bwillaert/WaterLevelSensor/Measurements/capacitive_oscillator_pin3.jpg

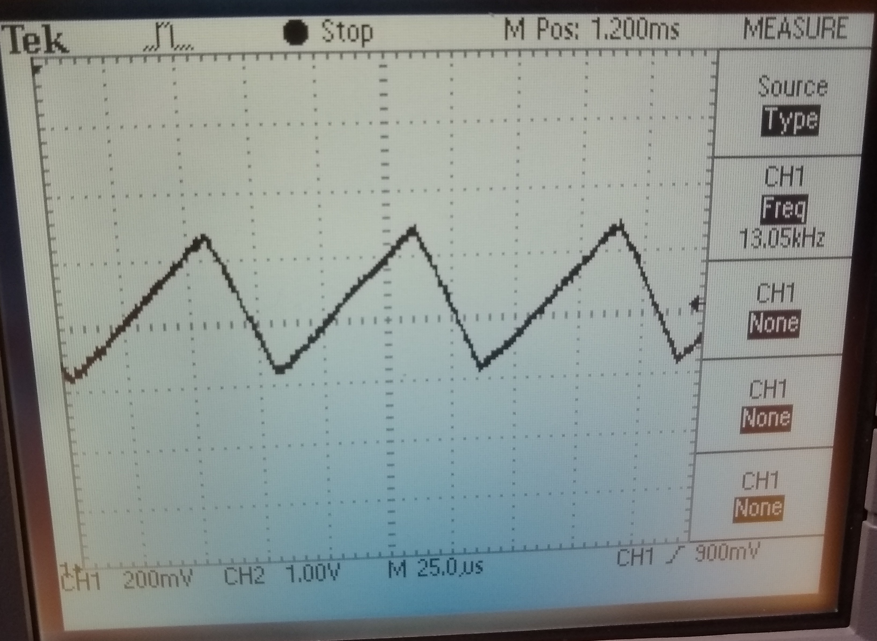
Measurements/capacitive_oscillator_pin3.jpg
