bwillaert/WaterLevelSensor/Proto/IMG_20221228_154319753.jpg

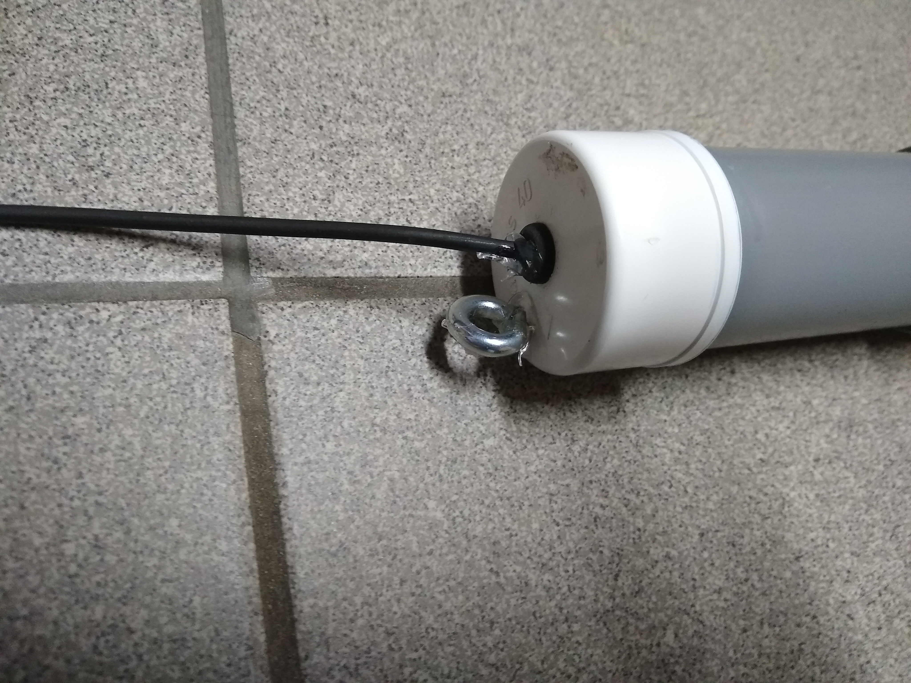
Proto/IMG_20221228_154319753.jpg
