bwillaert/WaterLevelSensor/SW/WaterLevelSensor/README.md

# WaterLevelSensor
Capacitive water level sensor
