bwillaert/WaterLevelSensor/Components/Watersensor.docx

CONRAD

Wartel flexible 2.5 mm min

https://www.conrad.be/nl/p/lapp-53015800-wartel-pg7-polyamide-zwart-ral-9005-1-stuk-s-526869.html

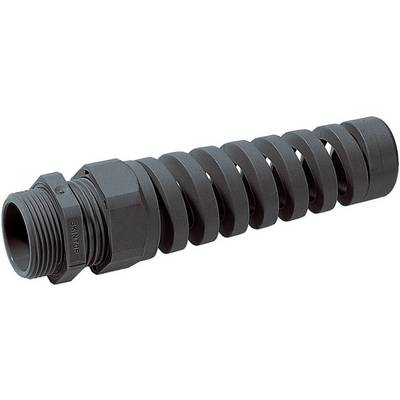
[picture p3: figure]
LAPP 53015800 Wartel PG7 Polyamide Zwart (RAL 9005) 1 stuk(s)

Wartel vast 2.5 mm min

https://www.conrad.be/nl/p/lapp-53015200-wartel-pg7-polyamide-zwart-ral-9005-1-stuk-s-527168.html

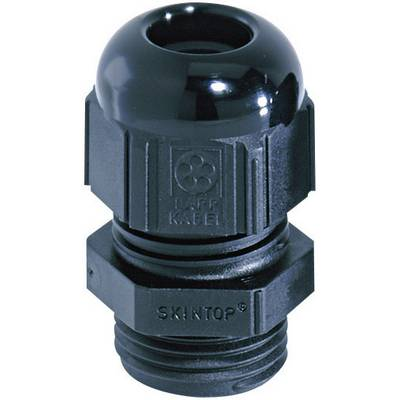
[picture p4: figure]
LAPP 53015200 Wartel PG7 Polyamide Zwart (RAL 9005) 1 stuk(s)

Moer wartel PG7
https://www.conrad.be/nl/p/lapp-skintop-gmp-gl-pg7-contramoer-pg7-polyamide-zwart-ral-9005-1-stuk-s-527078.html

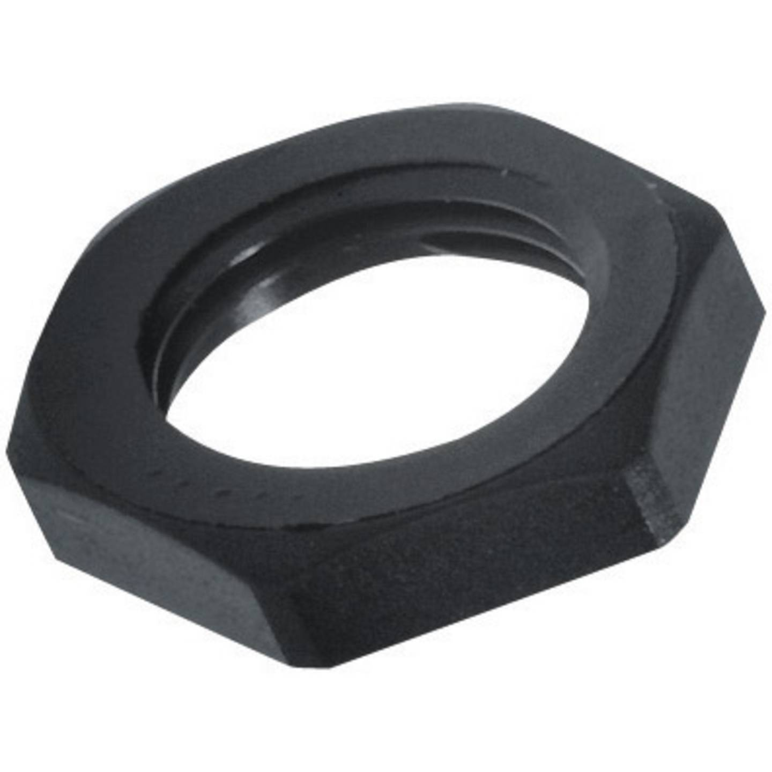
[picture p5: figure]

Behuizing controller

https://www.conrad.be/nl/p/fibox-ta131007-wandbehuizing-130-x-95-x-65-abs-grijs-wit-ral-7035-1-stuk-s-533265.html

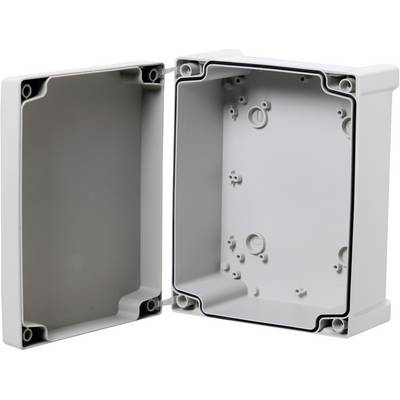
[picture p6: figure]
Fibox TA131007 Wandbehuizing 130 x 95 x 65 ABS Grijs-wit (RAL 7035) 1 stuk(s)

Behuizing sensor

https://www.conrad.be/nl/p/tru-components-wf20-2-tc-6649484-universele-behuizing-63-x-58-x-35-abs-lichtgrijs-1-stuk-s-1662371.html

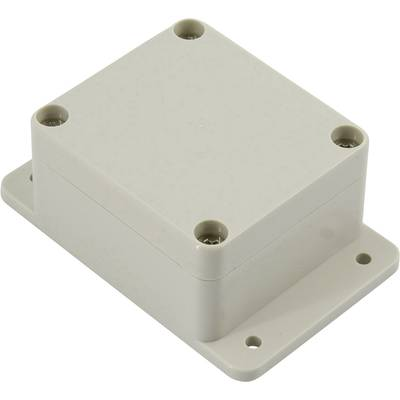
[picture p7: figure]
TRU COMPONENTS WF3-2 TC-6649488 Universele behuizing 115 x 55 x 90 ABS Lichtgrijs 1 stuk(s)

https://www.conrad.be/nl/p/hammond-electronics-1591mf2sgy-universele-behuizing-85-x-56-x-26-abs-grijs-1-stuk-s-485555.html

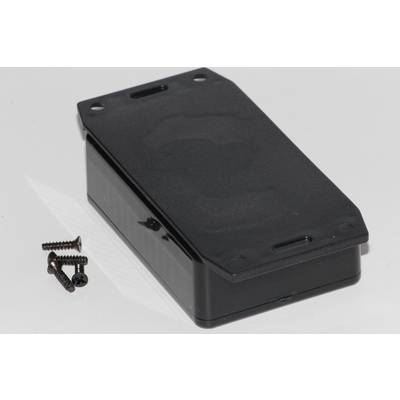
[picture p8: figure]
Hammond Electronics 1591MF2SGY Universele behuizing 85 x 56 x 26 ABS Grijs 1 stuk(s)

https://www.conrad.be/nl/p/hammond-electronics-1591bf2sbk-universele-behuizing-112-x-62-x-31-abs-zwart-1-stuk-s-485537.html

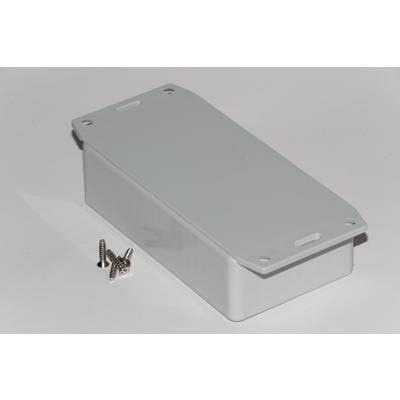
[picture p9: figure]
Hammond Electronics 1591BF2SBK Universele behuizing 112 x 62 x 31 ABS Zwart 1 stuk(s)

https://www.conrad.be/nl/p/tru-components-tc-10860484-universele-behuizing-105-x-70-x-40-polycarbonaat-lichtgrijs-1-stuk-s-2715121.html

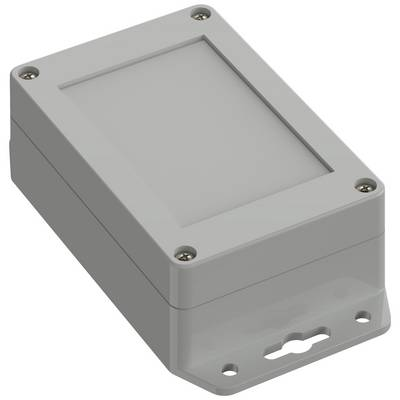
[picture p10: figure]
TRU COMPONENTS TC-10860484 Universele behuizing 105 x 70 x 40 Polycarbonaat Lichtgrijs 1 stuk(s)

Druktoets calibratie

https://www.conrad.be/nl/p/namae-electronics-jtp-1130l-druktoets-12-v-dc-0-05-a-1x-uit-aan-moment-1-stuk-s-705338.html

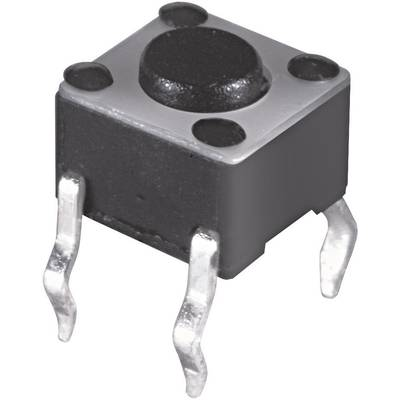
[picture p11: figure]
Namae Electronics JTP-1130L Druktoets 12 V/DC 0.05 A 1x uit/(aan) Moment 1 stuk(s)

Rode toets:
https://www.conrad.be/nl/p/te-connectivity-tactile-switchestactile-switches-3-1825910-1-amp-2455174.html

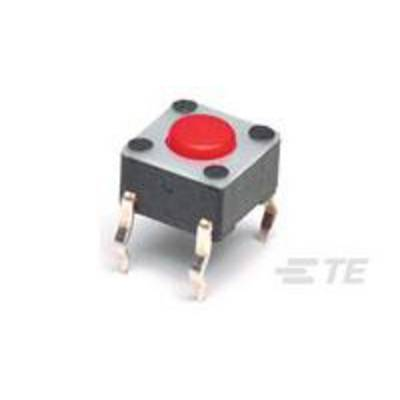
[picture p12: figure]
TE Connectivity Tactile SwitchesTactile Switches 3-1825910-1 AMP

Druktoets meter

https://www.conrad.be/nl/p/tru-components-tc-mt312sw-druktoets-moment-1-stuk-s-1589484.html

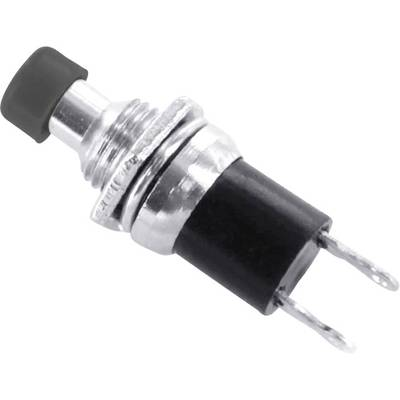
[picture p13: figure]
TRU COMPONENTS TC-MT312SW Druktoets Moment 1 stuk(s)

https://www.conrad.be/nl/p/tru-components-tc-r13-507a-05bk-druktoets-250-v-ac-3-a-1x-uit-aan-moment-1-stuk-s-1587737.html

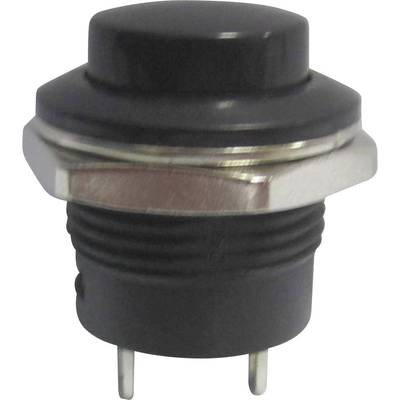
[picture p14: figure]
TRU COMPONENTS TC-R13-507A-05BK Druktoets 250 V/AC 3 A 1x uit/(aan) Moment 1 stuk(s)

Meter 100 microA

https://www.conrad.be/nl/p/analoog-inbouwmeetapparaat-voltcraft-am-60x46-100-a-dc-100-a-n-a-103537.html

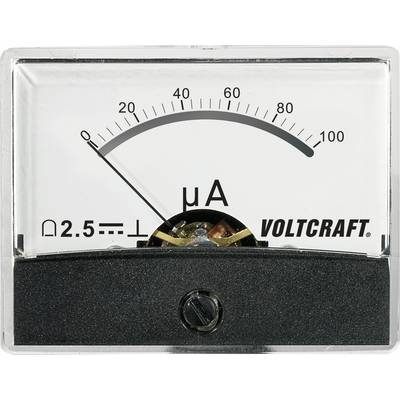
[picture p15: figure]
Analoog inbouwmeetapparaat VOLTCRAFT AM-60X46/100µA/DC 100 µA N/A

https://nl.aliexpress.com/item/32963269702.html

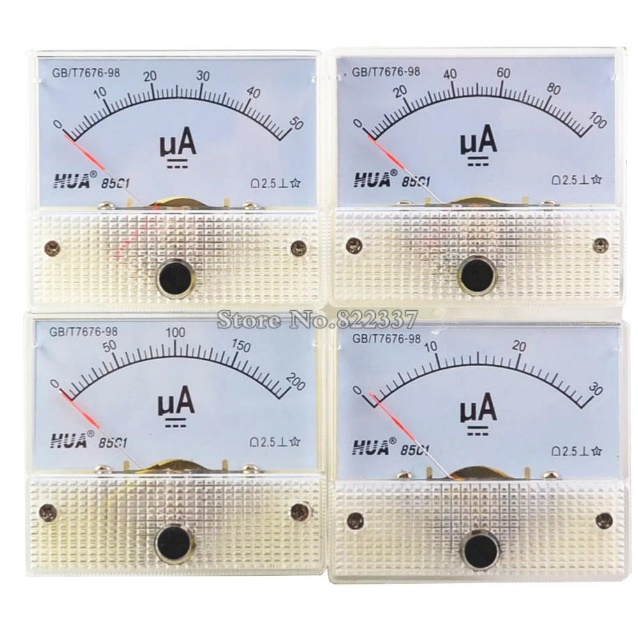
[picture p16: figure]

https://elektrodump.nl/nl/paneelmeters/1827-paneelmeter.html

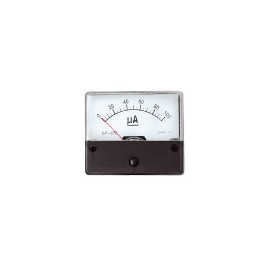
[picture p17: figure]
paneelmeter

Stereo chassis input

https://www.conrad.be/nl/p/tru-components-718817-jackplug-3-5-mm-bus-inbouw-verticaal-aantal-polen-3-stereo-zwart-1-stuk-s-718817.html

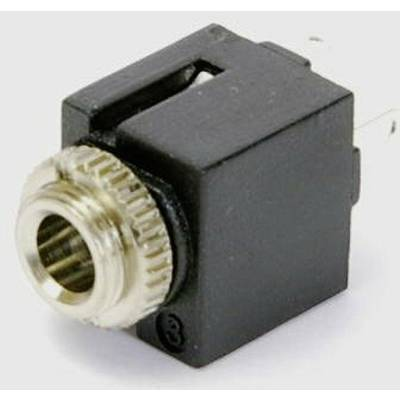
[picture p18: figure]
TRU COMPONENTS 718817 Jackplug 3.5 mm Bus, inbouw verticaal Aantal polen: 3 Stereo Zwart 1 stuk(s)

Stereo jack plug

https://www.conrad.be/nl/p/tru-components-595194-jackplug-3-5-mm-stekker-recht-aantal-polen-3-stereo-zwart-1-stuk-s-1567385.html

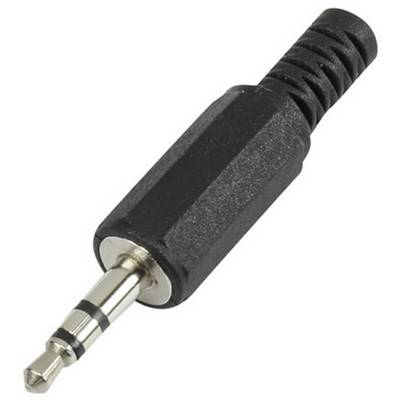
[picture p19: figure]
TRU COMPONENTS 595194 Jackplug 3.5 mm Stekker, recht Aantal polen: 3 Stereo Zwart 1 stuk(s)

555

https://www.conrad.be/nl/p/on-semiconductor-lm555cn-clock-timing-ic-timer-oscillator-dip-8-1253093.html

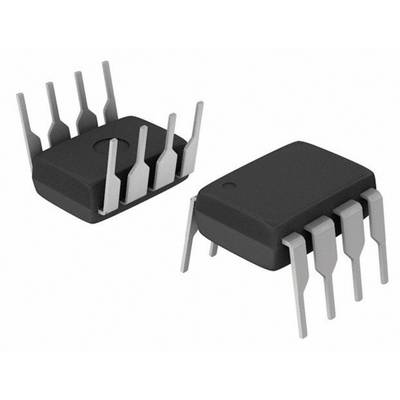
[picture p20: figure]
ON Semiconductor LM555CN Clock/timing-IC - timer, oscillator DIP-8

Kabel sensor

https://www.conrad.be/nl/p/kash-1339360-microfoonkabel-2-x-0-12-mm-zwart-per-meter-1339360.html

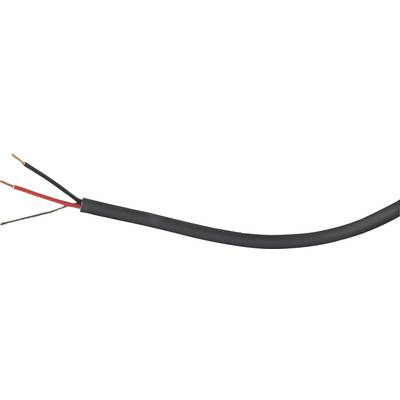
[picture p21: figure]
Kash 1339360 Microfoonkabel 2 x 0.12 mm² Zwart per meter

Kabel 3 aders

https://www.conrad.be/nl/p/lapp-28203-1-datakabel-unitronic-liyy-3-x-0-14-mm-kiezel-grijs-ral-7032-per-meter-602153.html

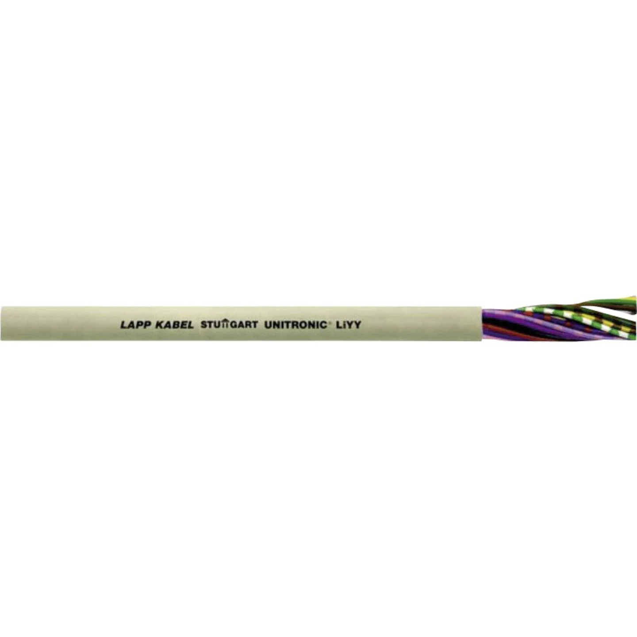
[picture p22: figure]

https://www.conrad.be/nl/p/faber-kabel-liyy-stuurstroomkabel-3-x-0-34-mm-grijs-030220-per-meter-1152513.html

>>>> https://www.conrad.be/nl/p/faber-kabel-liyy-stuurstroomkabel-3-x-0-14-mm-grijs-030175-per-meter-1152511.htm

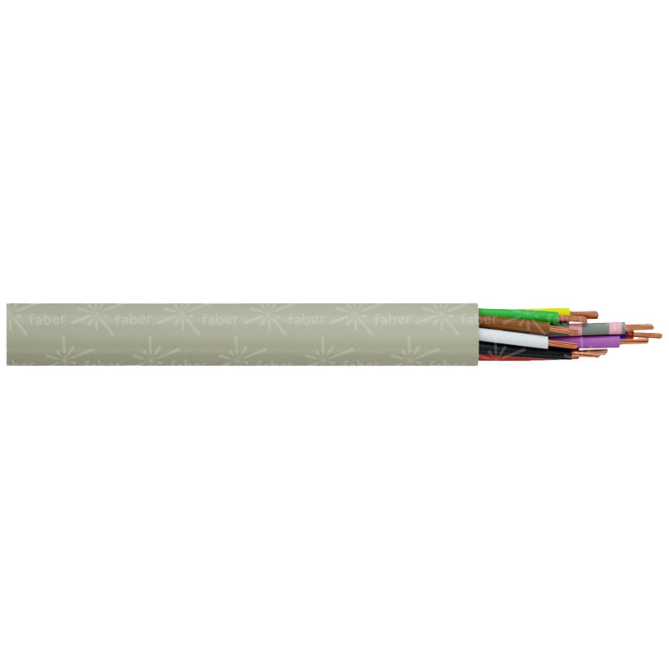
[picture p23: figure]

LED rood / groen

https://www.conrad.be/nl/p/vossloh-schwabe-cqx-95-led-meerkleurig-rood-groen-rond-5-mm-90-mcd-70-mcd-60-20-ma-2-v-2-1-v-185000.html

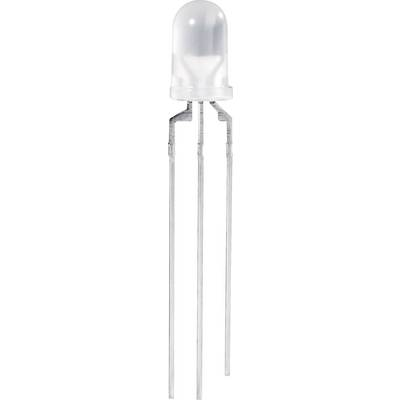
[picture p24: figure]
Vossloh Schwabe CQX 95 LED meerkleurig Rood, Groen Rond 5 mm 90 mcd, 70 mcd 60 ° 20 mA 2 V, 2.1 V

Multifuse 100 mA

https://www.conrad.be/nl/p/eska-frx010-60f-ptc-zekering-drempelstroom-i-h-0-1-a-60-v-l-x-b-x-h-5-7-x-3-1-x-18-5-mm-1-stuk-s-524748.html

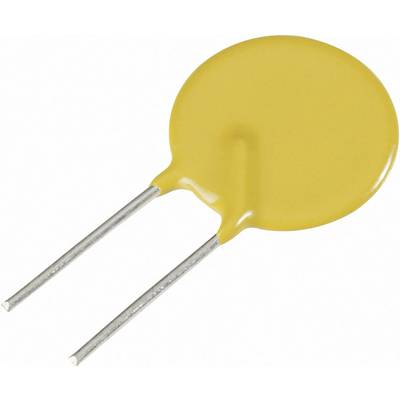
[picture p25: figure]
ESKA FRX010-60F PTC-zekering Drempelstroom I(H) 0.1 A 60 V (l x b x h) 5.7 x 3.1 x 18.5 mm 1 stuk(s)

Eindkappen sensor draad

https://www.conrad.be/nl/p/hellermanntyton-416-00000-warmkrimpende-eindkap-nominale-binnen-voor-krimpen-3-mm-1-stuk-s-542462.html

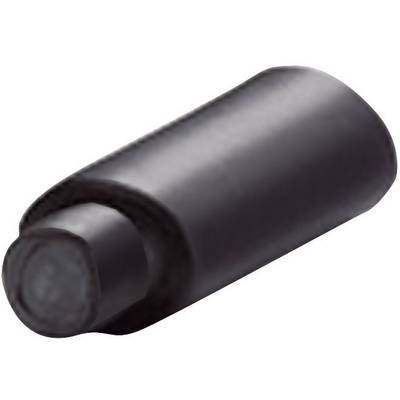
[picture p26: figure]
HellermannTyton 416-00000 Warmkrimpende eindkap Nominale binnen-Ø (voor krimpen): 3 mm 1 stuk(s)

https://www.conrad.be/nl/p/tru-components-1592743-eindkap-niet-krimpend-nominale-binnen-voor-krimpen-3-mm-100-stuk-s-1592743.html

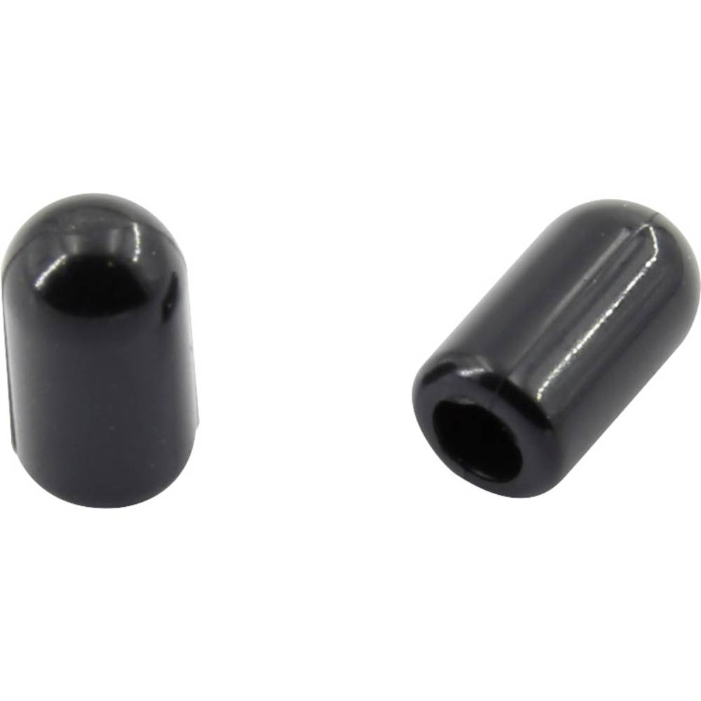
[picture p27: figure]

HUBO 32 mm PVC behuizing sensor:

https://www.hubo.be/nl/p/scala-stop-met-schroef-32mm-grijs/815025.html

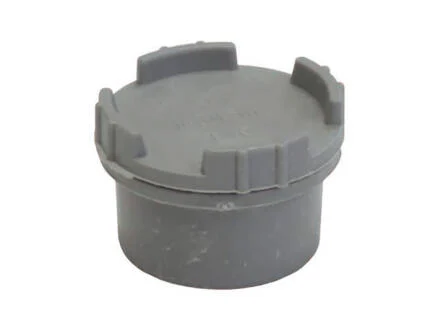
[picture p28: figure]

https://www.hubo.be/nl/p/scala-lijmmof-32mm-grijs/815019.html

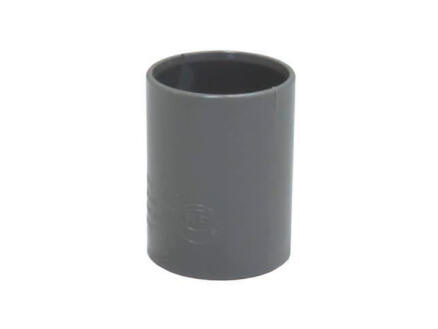
[picture p29: figure]

Eindkap 32 mm wit
https://www.gamma.be/nl/assortiment/martens-eindkap-voor-buis-pvc-wit-32-mm/p/B120335

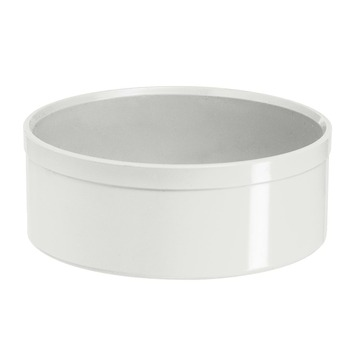
[picture p30: figure]

Eindkap 40 mm Brico grijs

https://www.brico.be/nl/bouwmaterialen/waterafvoer/afvoer-en-rioleringsbuizen/martens-eindkap-voor-buis-40-mm/4207159

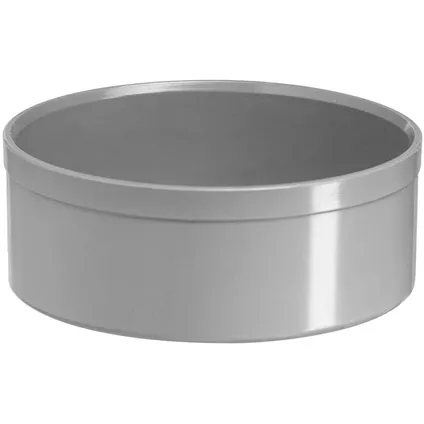
[picture p31: figure]
