bwillaert/WaterLevelSensor/PCB/WLS3/WLS3/wls3.pdf/WLS3.pdf

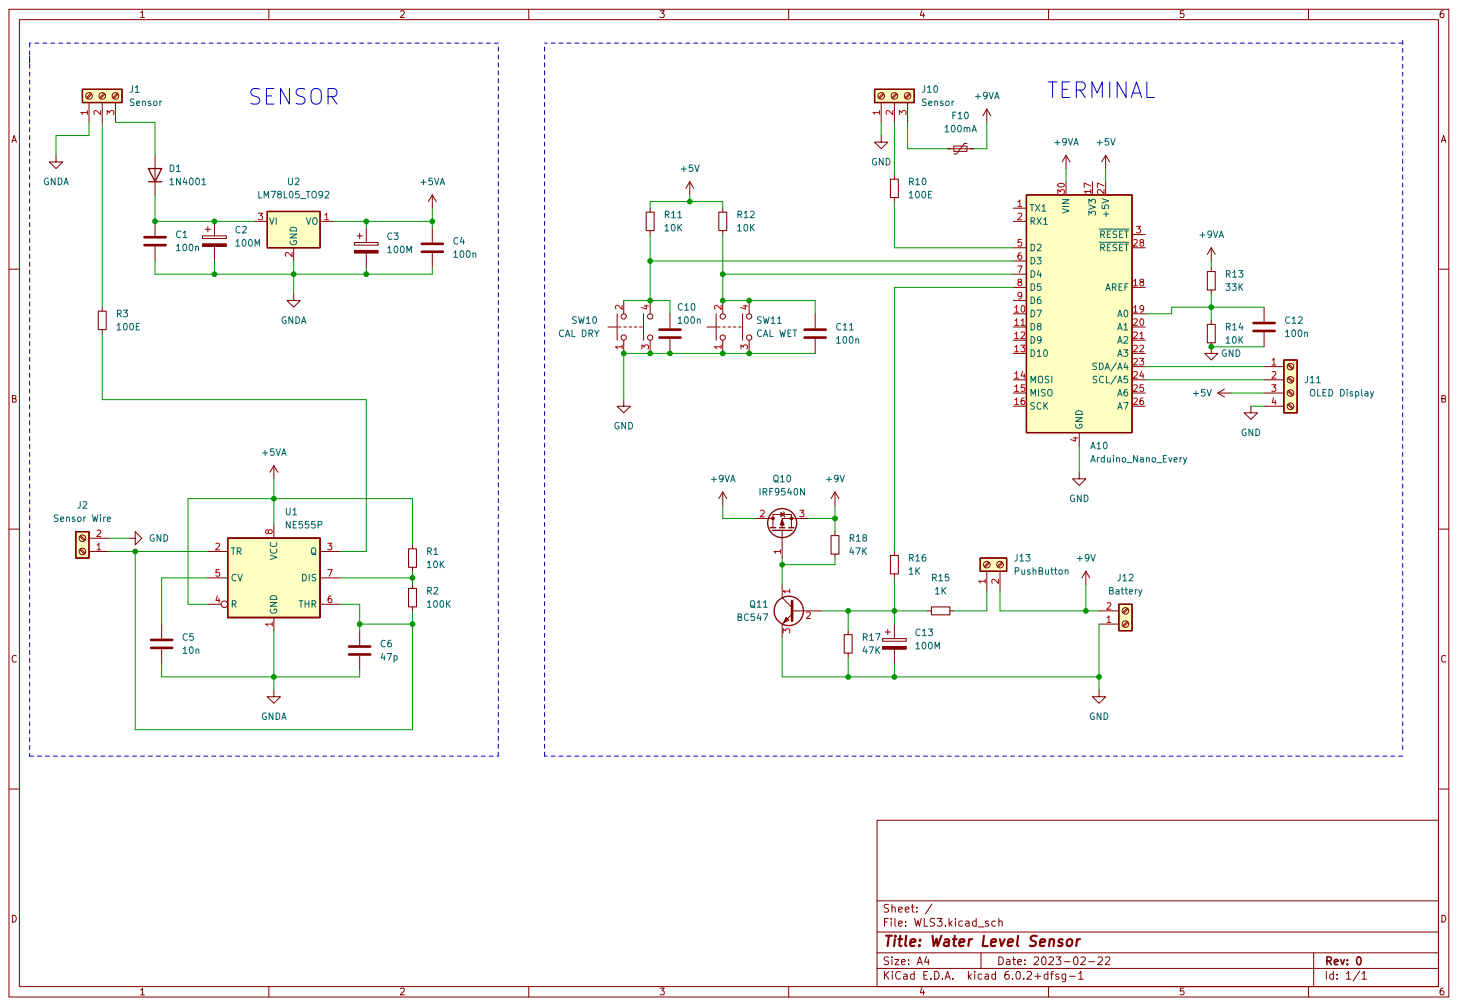
[picture p32: page 1]

File: WLS3.kicad_sch Sheet: /
Id: 1/1 Title: Water Level Sensor
