bwillaert/WaterLevelSensor/PCB/WLS5/WLS5/WLS5.kicad_pcb

## KiCad design PCB/WLS5/WLS5/WLS5.kicad_pcb (2023-09-03)

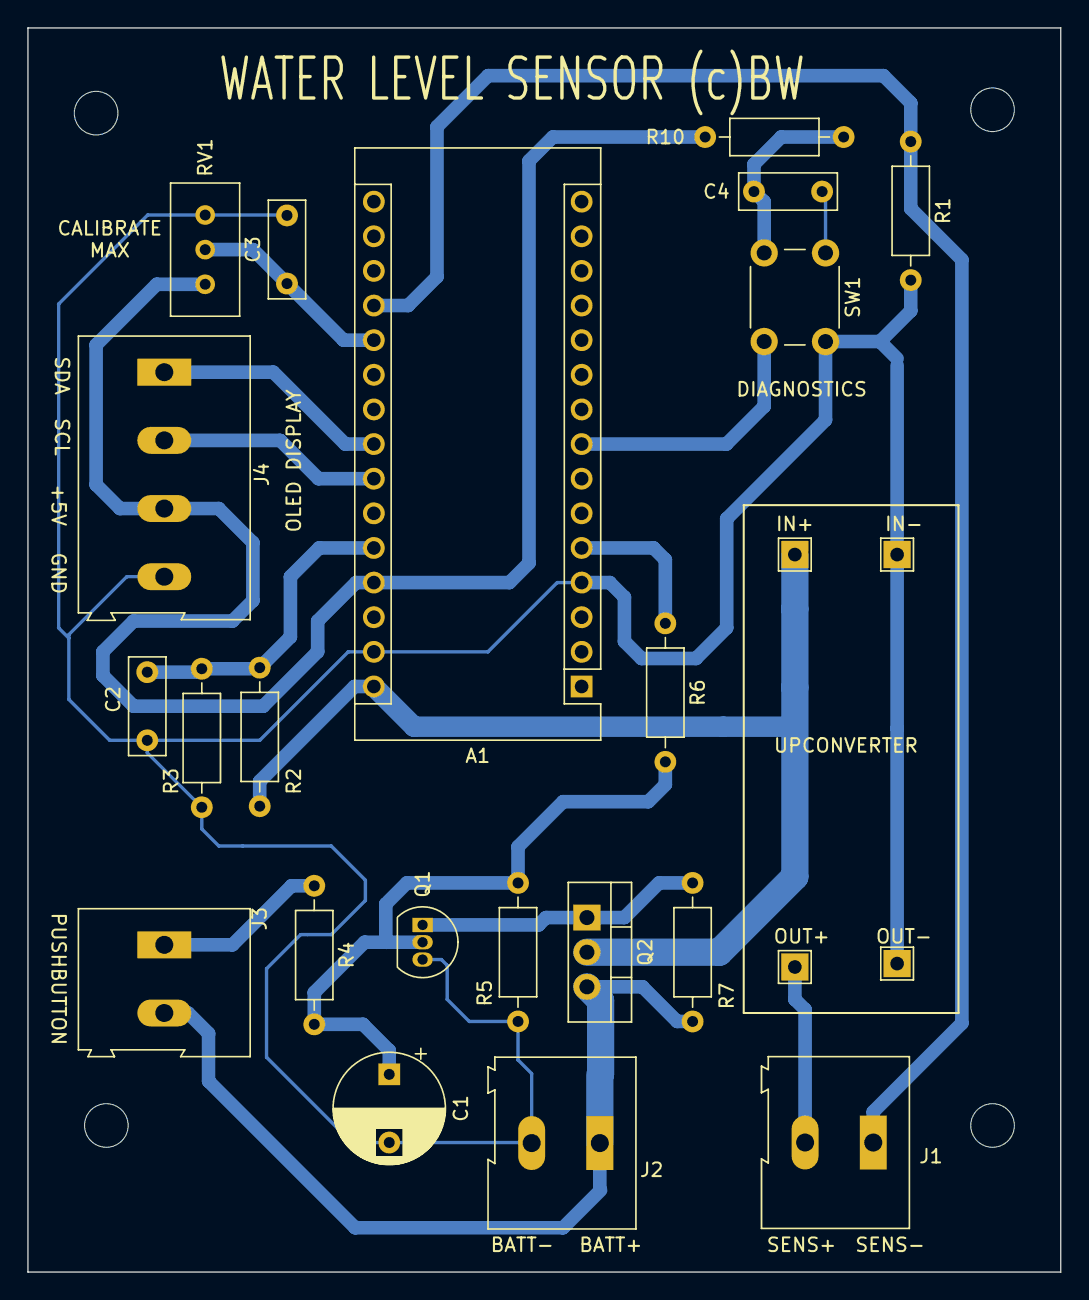
[picture p33: board WLS5.kicad_pcb from above]

Board: 2 copper layers, 75.8 x 91.2 mm, 29 parts (0 on the bottom side), 15 nets.

Parts:
A1: Arduino_Nano_Every; Arduino_Nano
C1: 100M; CP_Radial_D8.0mm_P5.00mm
C2, C3, C4: 100n; C_Disc_D7.0mm_W2.5mm_P5.00mm
H1, H2, H3, H4: MountingHole; MountingHole_3.2mm_M3
IN+: IN+; TestPoint_THTPad_2.0x2.0mm_Drill1.0mm
IN-: IN-; TestPoint_THTPad_2.0x2.0mm_Drill1.0mm
J1: Sensor; TerminalBlock_Altech_AK300-2_P5.00mm
J2: Battery; TerminalBlock_Altech_AK300-2_P5.00mm
J3: PushButton; TerminalBlock_Altech_AK300-2_P5.00mm
J4: OLED Display; TerminalBlock_Altech_AK300-4_P5.00mm
OUT+: UP+; TestPoint_THTPad_2.0x2.0mm_Drill1.0mm
OUT-: UP-; TestPoint_THTPad_2.0x2.0mm_Drill1.0mm
Q1: BC547; TO-92_Inline
Q2: IRF9540N; TO-220-3_Vertical
R1: 220E; R_Axial_DIN0207_L6.3mm_D2.5mm_P10.16mm_Horizontal
R2: 33K; R_Axial_DIN0207_L6.3mm_D2.5mm_P10.16mm_Horizontal
R3, R10: 10K; R_Axial_DIN0207_L6.3mm_D2.5mm_P10.16mm_Horizontal
R4, R6: 1K; R_Axial_DIN0207_L6.3mm_D2.5mm_P10.16mm_Horizontal
R5, R7: 47K; R_Axial_DIN0207_L6.3mm_D2.5mm_P10.16mm_Horizontal
RV1: Calibrate max; Potentiometer_Bourns_3296W_Vertical
SW1: DIAGNOSTICS; SW_PUSH_6mm

Connections:
+5V: A1.27 (+5V), J4.3, R10.1, RV1.1
+9V: J2.1, J3.2, Q2.3 (S), R7.1
+9VA: A1.30 (VIN), IN+.1, Q2.2 (D), R2.1
GND: A1.4 (GND), A1.29 (GND), C1.2, C2.2, C3.2, C4.2, IN-.1, J2.2, J4.4, OUT-.1, Q1.3 (E), R1.2, R3.2, R5.2, RV1.3, SW1.1
unnamed: A1.5 (D2), R6.1
unnamed: A1.8 (D5), C4.1, R10.2, SW1.2
unnamed: A1.20 (A1), C3.1, RV1.2
unnamed: A1.23 (SDA/A4), J4.1
unnamed: A1.24 (SCL/A5), J4.2
unnamed: A1.26 (A7), C2.1, R2.2, R3.1
unnamed: C1.1, Q1.2 (B), R4.2, R5.1, R6.2
unnamed: A1.19 (A0), J1.1, R1.1
unnamed: J3.1, R4.1
unnamed: J1.2, OUT+.1
unnamed: Q1.1 (C), Q2.1 (G), R7.2
