bwillaert/WaterLevelSensor/PCB/WLS3/WLS3/WLS3.kicad_pcb

## KiCad design PCB/WLS3/WLS3/WLS3.kicad_pcb (2023-06-13)

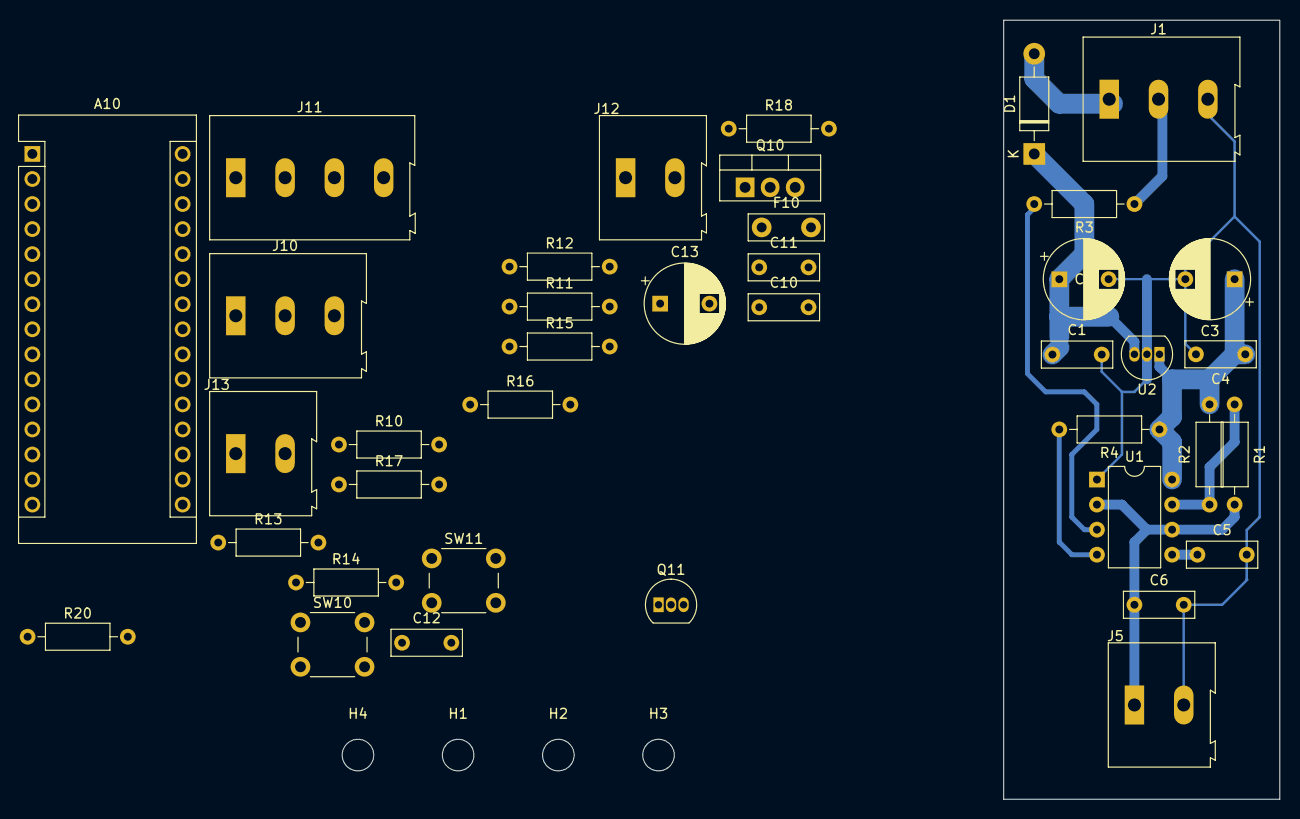
[picture p34: board WLS3.kicad_pcb from above]

Board: 2 copper layers, 28.0 x 79.0 mm, 43 parts (0 on the bottom side), 27 nets.

Parts:
A10: Arduino_Nano_Every; Arduino_Nano
C1, C4, C10, C11, C12: 100n; C_Disc_D7.0mm_W2.5mm_P5.00mm
C2, C3, C13: 100M; CP_Radial_D8.0mm_P5.00mm
C5: 10n; C_Disc_D7.0mm_W2.5mm_P5.00mm
C6: 22p; C_Disc_D7.0mm_W2.5mm_P5.00mm
D1: 1N4001; D_DO-41_SOD81_P10.16mm_Horizontal
F10: 100mA; C_Disc_D7.5mm_W2.5mm_P5.00mm
H1, H2, H3, H4: MountingHole; MountingHole_3.2mm_M3
J1, J10: Sensor; TerminalBlock_Altech_AK300-3_P5.00mm
J5: Sensor Wire; TerminalBlock_Altech_AK300-2_P5.00mm
J11: OLED Display; TerminalBlock_Altech_AK300-4_P5.00mm
J12: Battery; TerminalBlock_Altech_AK300-2_P5.00mm
J13: PushButton; TerminalBlock_Altech_AK300-2_P5.00mm
Q10: IRF9540N; TO-220-3_Vertical
Q11: BC547; TO-92_Inline
R1, R11, R12, R14: 10K; R_Axial_DIN0207_L6.3mm_D2.5mm_P10.16mm_Horizontal
R2: 100K; R_Axial_DIN0207_L6.3mm_D2.5mm_P10.16mm_Horizontal
R3, R10, R20: 100E; R_Axial_DIN0207_L6.3mm_D2.5mm_P10.16mm_Horizontal
R4: 10E; R_Axial_DIN0207_L6.3mm_D2.5mm_P10.16mm_Horizontal
R13: 33K; R_Axial_DIN0207_L6.3mm_D2.5mm_P10.16mm_Horizontal
R15, R16: 1K; R_Axial_DIN0207_L6.3mm_D2.5mm_P10.16mm_Horizontal
R17, R18: 47K; R_Axial_DIN0207_L6.3mm_D2.5mm_P10.16mm_Horizontal
SW10: CAL DRY; SW_PUSH_6mm_H5mm
SW11: CAL WET; SW_PUSH_6mm_H5mm
U1: NE555P; DIP-8_W7.62mm
U2: LM78L05_TO92; TO-92_Inline

Connections:
+5V: A10.27 (+5V), J11.3, R11.1, R12.1
+5VA: C3.1, C4.1, R1.1, R4.1, U1.8 (VCC), U2.1 (VO)
+9V: J12.2, J13.2, Q10.3 (S), R18.1
+9VA: A10.30 (VIN), F10.1, Q10.2 (D), R13.1
GND: A10.4 (GND), A10.29 (GND), C10.2, C11.2, C12.2, C13.2, J10.1, J11.4, J12.1, Q11.3 (E), R14.2, R17.2, SW10.1, SW11.1
GNDA: C1.2, C2.2, C3.2, C4.2, C5.2, C6.2, J1.3, J5.2, U1.1 (GND), U2.2 (GND)
unnamed: A10.2 (RX1), R20.2
unnamed: A10.5 (D2), R10.2
unnamed: A10.6 (D3), C10.1, R11.2, SW10.2
unnamed: A10.7 (D4), C11.1, R12.2, SW11.2
unnamed: A10.8 (D5), R16.1
unnamed: A10.19 (A0), C12.1, R13.2, R14.1
unnamed: A10.23 (SDA/A4), J11.1
unnamed: A10.24 (SCL/A5), J11.2
unnamed: C1.1, C2.1, D1.1 (K), U2.3 (VI)
unnamed: C5.1, U1.5 (CV)
unnamed: C6.1, J5.1, R2.2, U1.2 (TR), U1.6 (THR)
unnamed: C13.1, Q11.2 (B), R15.2, R16.2, R17.1
unnamed: D1.2 (A), J1.1
unnamed: F10.2, J10.3
unnamed: J10.2, R10.1, R20.1
unnamed: J13.1, R15.1
unnamed: Q10.1 (G), Q11.1 (C), R18.2
unnamed: R1.2, R2.1, U1.7 (DIS)
unnamed: J1.2, R3.1
unnamed: R4.2, U1.4 (R)
unnamed: R3.2, U1.3 (Q)
