bwillaert/WaterLevelSensor/PCB/WLS/WLS.brd

## EAGLE design PCB/WLS/WLS.brd (2023-05-29)

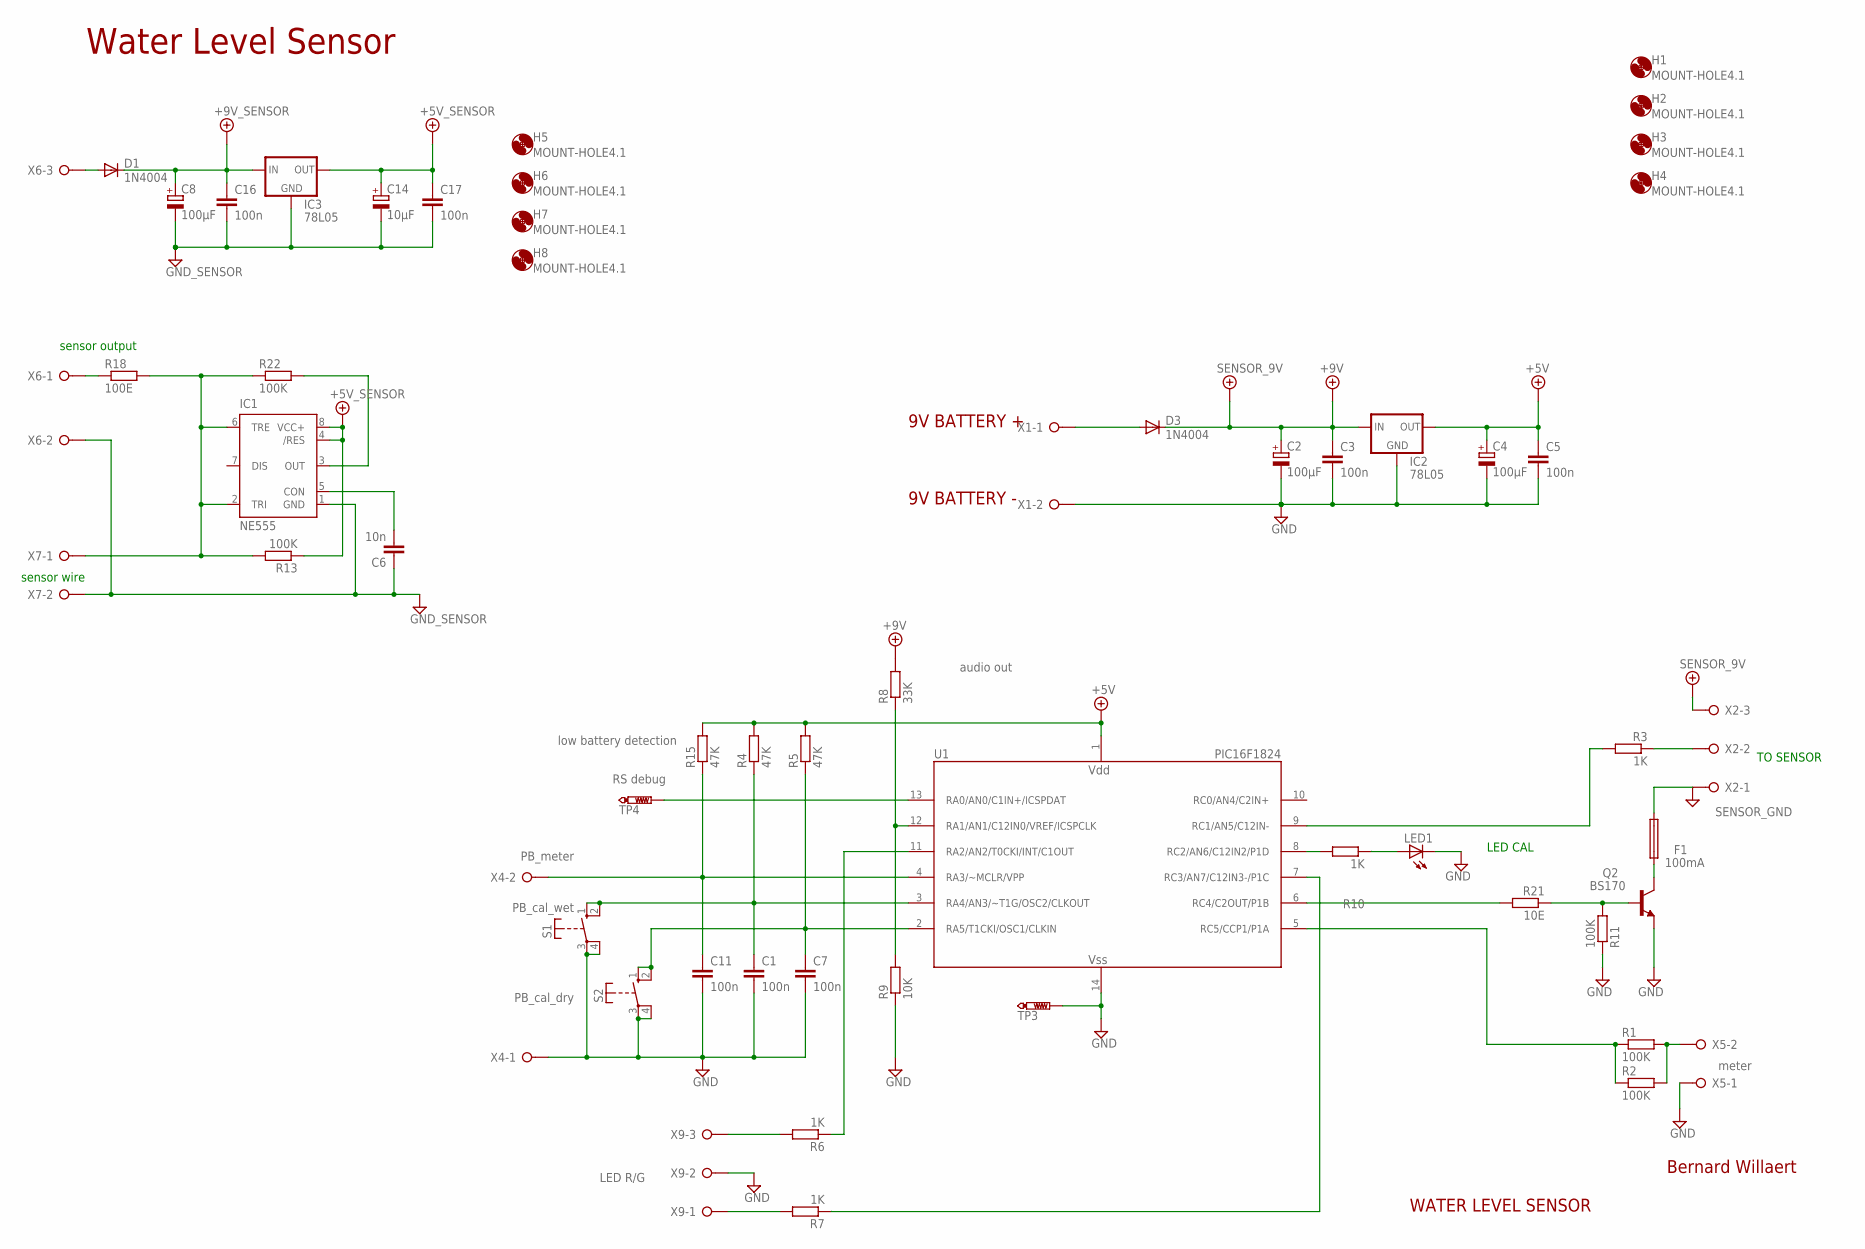
[picture p36: schematic WLS.sch]

Parts:
C1, C3, C5, C7, C11, C16, C17: 100n; C050-025X075
C2, C4, C8: 100µF; E5-6
C6: 10n; C050-025X075
C14: 10µF; E5-6
D1, D3: 1N4004; DO41-10
F1: 100mA; TR5
H1, H2, H3, H4, H5, H6, H7, H8: MOUNT-HOLE4.1; 4,1
IC1: NE555; DIL-08
IC2, IC3: 78L05; 78LXX
LED1: LED3MM
Q2: BS170; TO92-CBE
R1, R2, R11, R13, R22: 100K; 0207/10
R3, R6, R7, R10: 1K; 0207/10
R4, R5, R15: 47K; 0207/10
R8: 33K; 0207/10
R9: 10K; 0207/10
R18: 100E; 0207/10
R21: 10E; 0207/10
S1, S2: DTE6K
TP3, TP4: PTR1PAD1-17; P1-17
U1: PIC16F1824; DIP-14
X1, X4, X5, X7: W237-02P; W237-132
X2, X6, X9: W237-3E

Connections:
+5V: C4.+, C5.1, C14.+, C17.1, IC2.OUT, IC3.OUT, R4.2, R5.2, R15.2, U1.1 (VDD)
+12V: C2.+, C3.1, C8.+, C16.1, D1.C, D3.C, IC1.4 (/RES), IC1.8 (VCC+), IC2.IN, IC3.IN, R8.2, R13.1, X2.3
GND: C2.-, C3.2, C4.-, C5.2, C6.1, C8.-, C14.-, C16.2, C17.2, F1.2, IC1.1 (GND), IC2.GND, IC3.GND, LED1.K (C), Q2.E, R9.1, R11.1, TP3.TP, U1.14 (VSS), X1.2, X2.1, X5.1, X6.2, X7.2, X9.2
unnamed: IC1.2 (TRI), IC1.6 (TRE), R13.2, R18.2, R22.1, X7.1
unnamed: R21.2, U1.6 (RC4/C2OUT/P1B)
unnamed: IC1.3 (OUT), R22.2
unnamed: C1.1, R4.1, S1.1 (S), S1.2 (S), U1.3 (RA4/AN3/~T1G/OSC2/CLKOUT)
unnamed: R3.1, X2.2
unnamed: R3.2, U1.9 (RC1/AN5/C12IN-)
unnamed: R6.2, X9.3
unnamed: R7.2, X9.1
unnamed: R7.1, U1.7 (RC3/AN7/C12IN3-/P1C)
unnamed: C11.1, R15.1, U1.4 (RA3/~MCLR/VPP), X4.2
unnamed: R6.1, U1.11 (RA2/AN2/T0CKI/INT/C1OUT)
unnamed: C6.2, IC1.5 (CON)
unnamed: R10.2, U1.8 (RC2/AN6/C12IN2/P1D)
unnamed: R18.1, X6.1
unnamed: R1.1, R2.1, U1.5 (RC5/CCP1/P1A)
unnamed: R1.2, R2.2, X5.2
unnamed: R8.1, R9.2, U1.12 (RA1/AN1/C12IN0/VREF/ICSPCLK)
unnamed: Q2.B, R11.2, R21.1
unnamed: D1.A, X6.3
unnamed: TP4.TP, U1.13 (RA0/AN0/C1IN+/ICSPDAT)
unnamed: LED1.A, R10.1
unnamed: F1.1, Q2.C
unnamed: C1.2, C7.2, C11.2, S1.3, S1.4, S2.3, S2.4, X4.1
unnamed: C7.1, R5.1, S2.1 (S), S2.2 (S), U1.2 (RA5/T1CKI/OSC1/CLKIN)
unnamed: D3.A, X1.1

Notes on the sheet:
Water Level Sensor
low battery detection
WATER LEVEL SENSOR
Bernard Willaert
9V BATTERY +
9V BATTERY -
PB_meter
meter
audio out
sensor wire
sensor output
RS debug
TO SENSOR
PB_cal_wet
PB_cal_dry
LED R/G
LED CAL

Board: 2 copper layers, 56 parts (0 on the bottom side), 28 nets, no tracks yet.
