bwillaert/WaterLevelSensor/(commit log)

2023-05-29 WaterLevelSensor repo init
    [Calc_555.xls, WLS.brd, WLS.kicad_pcb, WLS.kicad_sch, WLS.sch, WLS2.cfg, WLS2.sch, WLS3.cfg]
2023-06-13 Updated PCB sensor
    [WLS3.kicad_pcb, WLS3.kicad_sch]
2023-09-03 Added WLS4 and WLS5
    [WLS4.kicad_sch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]
2023-09-22 Averaging the current sensor value
2023-12-21 Added arduino_for_dummies
